drewmoseley/led-channel-system/(commit log)

2026-10-02 Initial commit: parametric OpenSCAD LED channel system
    [led_accessories_v3.scad, led_channel.scad]
2026-10-02 Document mount_count in README
2026-10-02 Add diffuser_width_clearance parameter
    Reduces the diffuser width by a total of 0.1 mm by default, split evenly
    between both sides, so the diffuser slides into its groove or drops into
    its pocket more easily. Applied to the straight channel diffuser and to
    the corner and tee diffusers.
    [led_accessories_v3.scad, led_channel.scad]
2026-10-04 Add optional second diffuser groove; retune preset for 12V 60/m shelf units
    [led_channel.scad]
2026-10-07 Add strip retention lips; widen channel to strip_clearance 1.0
    Lips over each strip PCB edge hold the strip if the adhesive fails
    (strip_lip, strip_lip_overlap, strip_lip_thickness, strip_lip_clearance,
    strip_led_width). strip_clearance goes 0.5 -> 1.0 in the channel and
    accessories. Preset renamed "Bar Shelf Lighting" and carries the lip
    values. README updated.
    [led_accessories_v3.scad, led_channel.scad]
2026-10-19 Add RGBWW 10mm parameter set
    10 mm wide, 1 mm thick strip with 5 mm wide LEDs; air_gap 5.5.
2026-10-19 README: add diffuser print settings
